feliksdd/poa-sensor/bom/bom.csv

Ref | Qty | Value | MPN | LCSC | Footprint | Assembly | Notes
CELL1 | 1 | KXOB25-14X1F | KXOB25-14X1F-TR |  | POA:KXOB25-14X1F | MANUAL | Manual procurement via group order; DigiKey KXOB25-14X1FCT-ND; no LCSC equivalent assigned
RSH1 | 1 | 1R 0.1% 25ppm/K | RT0805BRD071RL | C865286 | Resistor_SMD:R_0805_2012Metric | FITTED_DIRECT | True Kelvin routing; 0805 shunt
R4 | 1 | 100R | 0603WAF1000T5E | C22775 | Resistor_SMD:R_0603_1608Metric | FITTED_DIRECT
R5 | 1 | 100R | 0603WAF1000T5E | C22775 | Resistor_SMD:R_0603_1608Metric | FITTED_DIRECT
C3 | 1 | 100nF | CC0603KRX7R9BB104 | C14663 | Capacitor_SMD:C_0603_1608Metric | FITTED_DIRECT
U1 | 1 | ADS1115IDGSR | ADS1115IDGSR | C37593 | Package_SO:MSOP-10_3x3mm_P0.5mm | FITTED_DIRECT
J1 | 1 | 3 m / 3 Paare / Loetpads |  |  | POA:POA_Cable_6pad | PCB_FEATURE | No duplicated I2C pullups in DIRECT mode
D1 | 1 | TPD2E2U06DRLR | TPD2E2U06DRLR | C1972959 | Package_TO_SOT_SMD:SOT-553 | FITTED_DIRECT
R12 | 1 | 10R analog filter | 0603WAF100JT5E | C22859 | Resistor_SMD:R_0603_1608Metric | FITTED_DIRECT
C6 | 1 | 1uF | CL21B105KBFNNNE | C28323 | Capacitor_SMD:C_0805_2012Metric | FITTED_DIRECT | 1uF 50V X7R +/-10%; JLCPCB Basic
C1 | 1 | 100nF | CC0603KRX7R9BB104 | C14663 | Capacitor_SMD:C_0603_1608Metric | FITTED_DIRECT
C2 | 1 | 1uF | CL21B105KBFNNNE | C28323 | Capacitor_SMD:C_0805_2012Metric | FITTED_DIRECT | 1uF 50V X7R +/-10%; JLCPCB Basic
R1 | 1 | 47k 0.1% | AR03BTCX4702 | C2828645 | Resistor_SMD:R_0603_1608Metric | FITTED_DIRECT | 0.1% 25ppm/K thin film
NTC1 | 1 | 10k NTC / 0402 | NTCG103JF103FT1 | C209959 | Resistor_SMD:R_0402_1005Metric | FITTED_DIRECT | 10k 1%; B25/50=3380K; 0402 height 0.50+/-0.05mm; cell underside 0.7mm above PCB
R2 | 1 | 47k 0.1% | AR03BTCX4702 | C2828645 | Resistor_SMD:R_0603_1608Metric | FITTED_DIRECT | 0.1% 25ppm/K thin film
R3 | 1 | 47k 0.1% | AR03BTCX4702 | C2828645 | Resistor_SMD:R_0603_1608Metric | FITTED_DIRECT | 0.1% 25ppm/K thin film
C4 | 1 | 100nF | CC0603KRX7R9BB104 | C14663 | Capacitor_SMD:C_0603_1608Metric | FITTED_DIRECT
C7 | 1 | 100nF | CC0603KRX7R9BB104 | C14663 | Capacitor_SMD:C_0603_1608Metric | FITTED_DIRECT
R6 | 1 | 0R DIRECT | 0603WAF0000T5E | C21189 | Resistor_SMD:R_0603_1608Metric | FITTED_DIRECT
R7 | 1 | 0R DIRECT | 0603WAF0000T5E | C21189 | Resistor_SMD:R_0603_1608Metric | FITTED_DIRECT
U2 | 1 | P82B715DR DNP | P82B715DR | C2649394 | Package_SO:SOIC-8_3.9x4.9mm_P1.27mm | DNP_BUFFER_OPTION | Remove R6/R7 before populating buffered option
R8 | 1 | 1k DNP | 0603WAF1001T5E | C21190 | Resistor_SMD:R_0603_1608Metric | DNP_BUFFER_OPTION | JLCPCB Basic; DNP in DIRECT; remove R6/R7 before buffered assembly
R9 | 1 | 1k DNP | 0603WAF1001T5E | C21190 | Resistor_SMD:R_0603_1608Metric | DNP_BUFFER_OPTION | JLCPCB Basic; DNP in DIRECT; remove R6/R7 before buffered assembly
R10 | 1 | 2.2k DNP | 0603WAF2201T5E | C4190 | Resistor_SMD:R_0603_1608Metric | DNP_BUFFER_OPTION | Remove R6/R7 before populating buffered option
R11 | 1 | 2.2k DNP | 0603WAF2201T5E | C4190 | Resistor_SMD:R_0603_1608Metric | DNP_BUFFER_OPTION | Remove R6/R7 before populating buffered option
C5 | 1 | 100nF DNP | CC0603KRX7R9BB104 | C14663 | Capacitor_SMD:C_0603_1608Metric | DNP_BUFFER_OPTION | Remove R6/R7 before populating buffered option
