feliksdd/poa-sensor/hardware/3dmodels/TDK_NTCG103JF103FT1.step

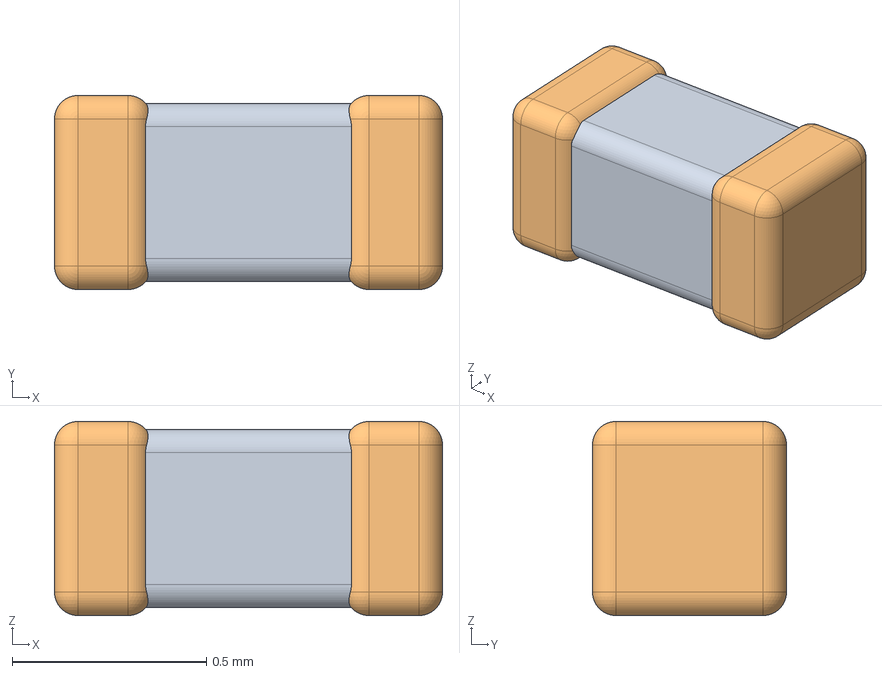
[picture p1: CAD file, 2026-11-11]
hardware/3dmodels/TDK_NTCG103JF103FT1.step
1.00 x 0.5 x 0.5 mm
