feliksdd/poa-sensor/hardware/3dmodels/KXOB25-14X1F.step

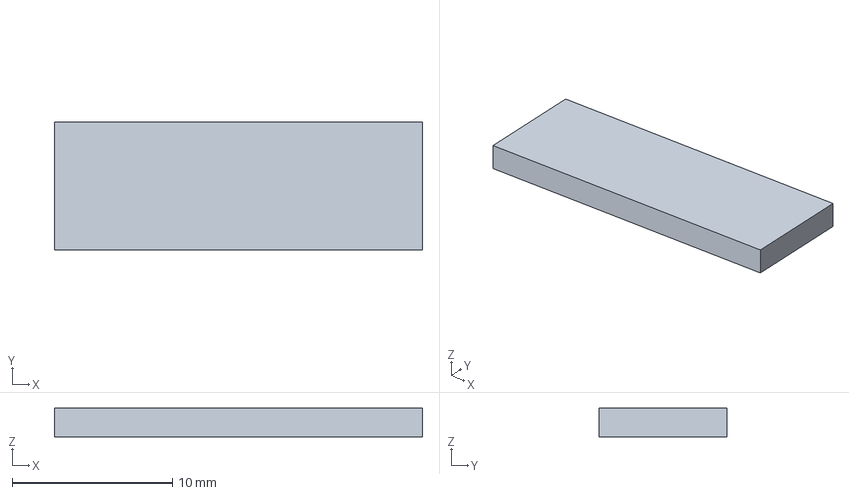
[picture p2: CAD file, 2026-09-30]
hardware/3dmodels/KXOB25-14X1F.step
23.0 x 8.00 x 1.80 mm
