feliksdd/poa-sensor/mechanical/manufacturer/Kradex_ZP60_60_40.pdf

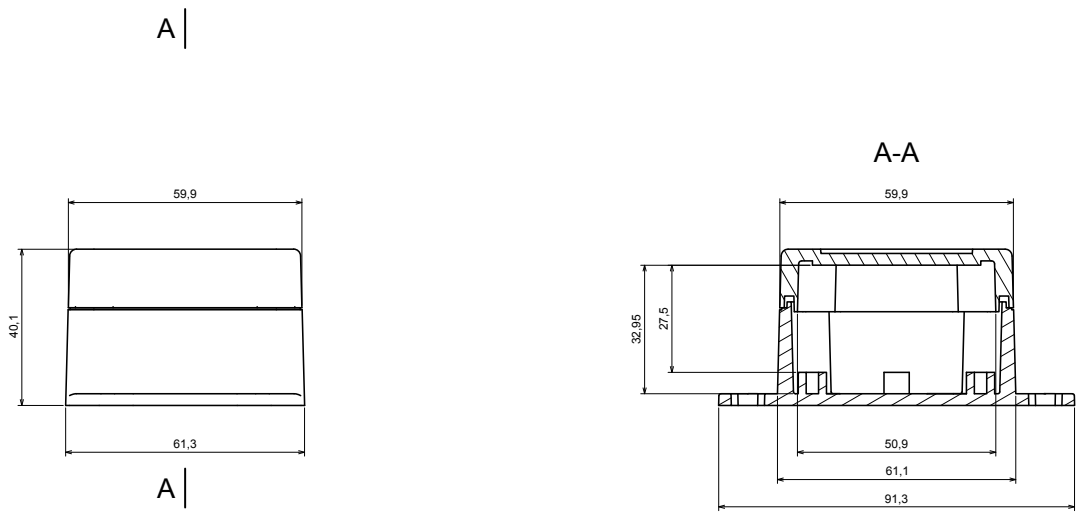
[picture p3: page 1]
Product model Format: A3 Scale 1:1; Tolerance: +/- 0.5 Material: PC, ABS Enclosure ZP60.60.40U TM - Assembly All rights reserved, Copyright Kradex 2020 AA

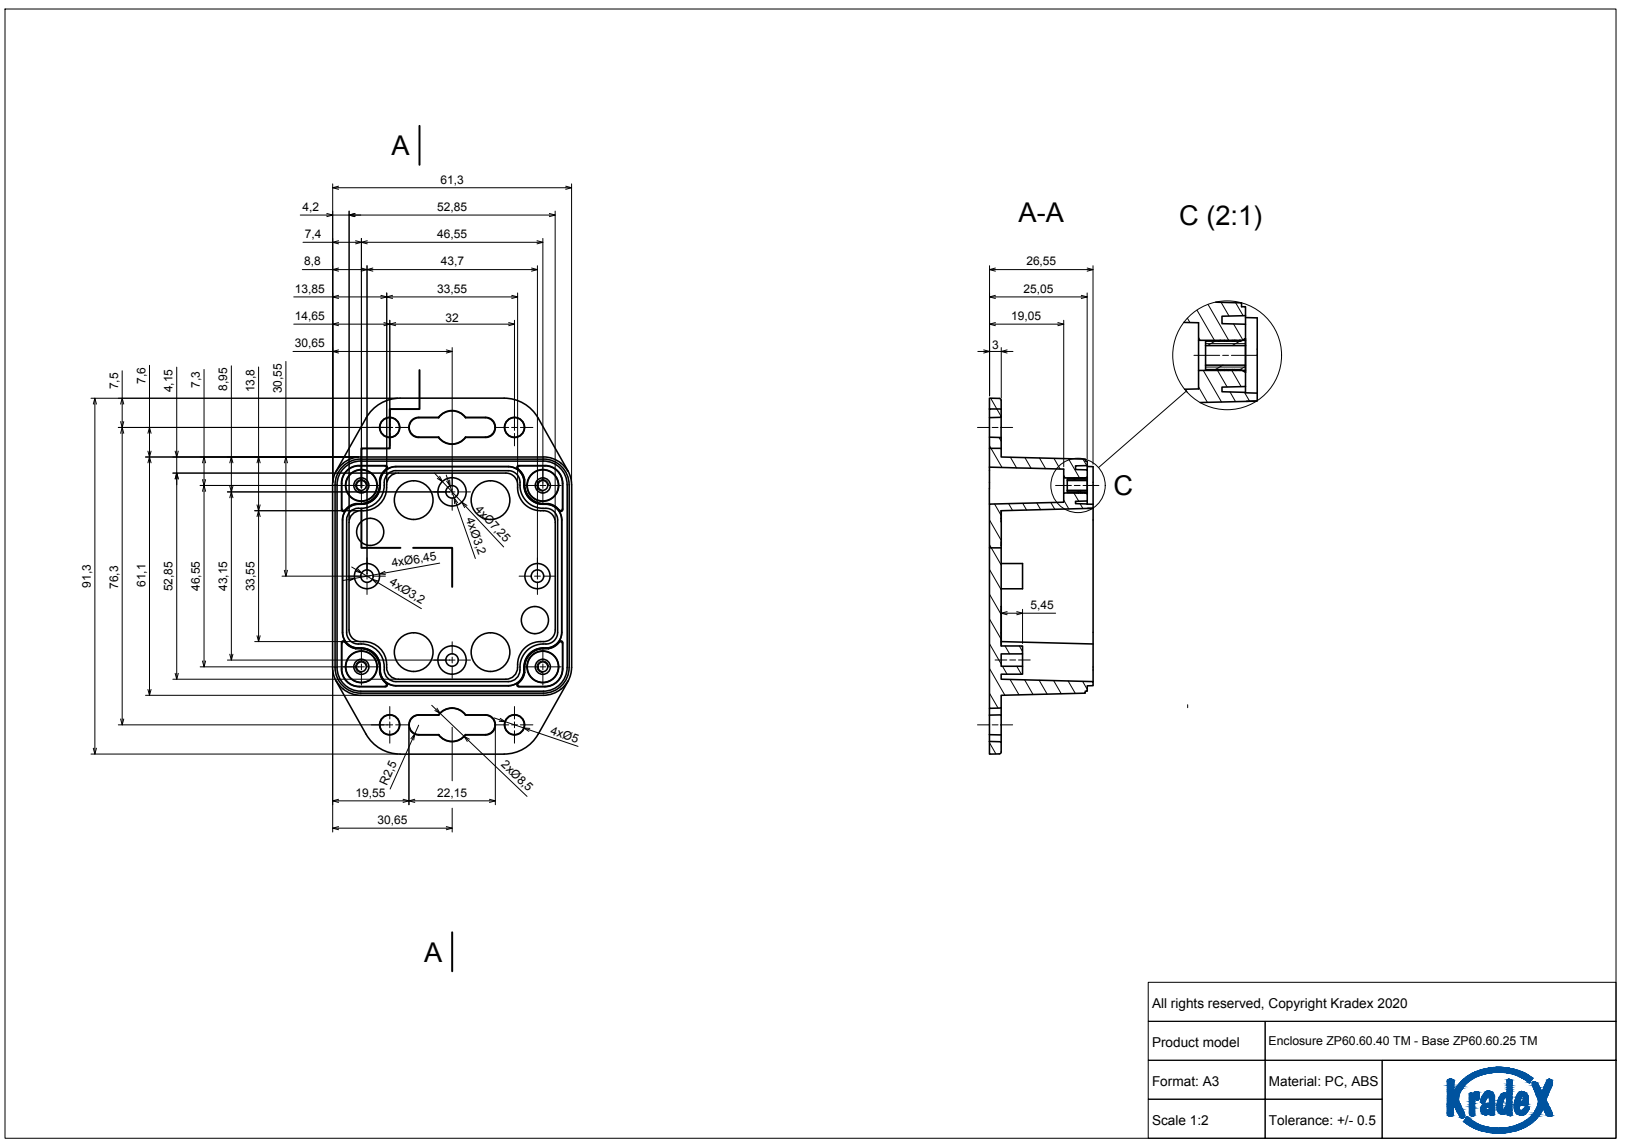
[picture p4: page 2]
Product model Format: A3 Scale 1:2; Tolerance: +/- 0.5 Material: PC, ABS Enclosure ZP60.60.40 TM - Base ZP60.60.25 TM All rights reserved, Copyright Kradex 2020

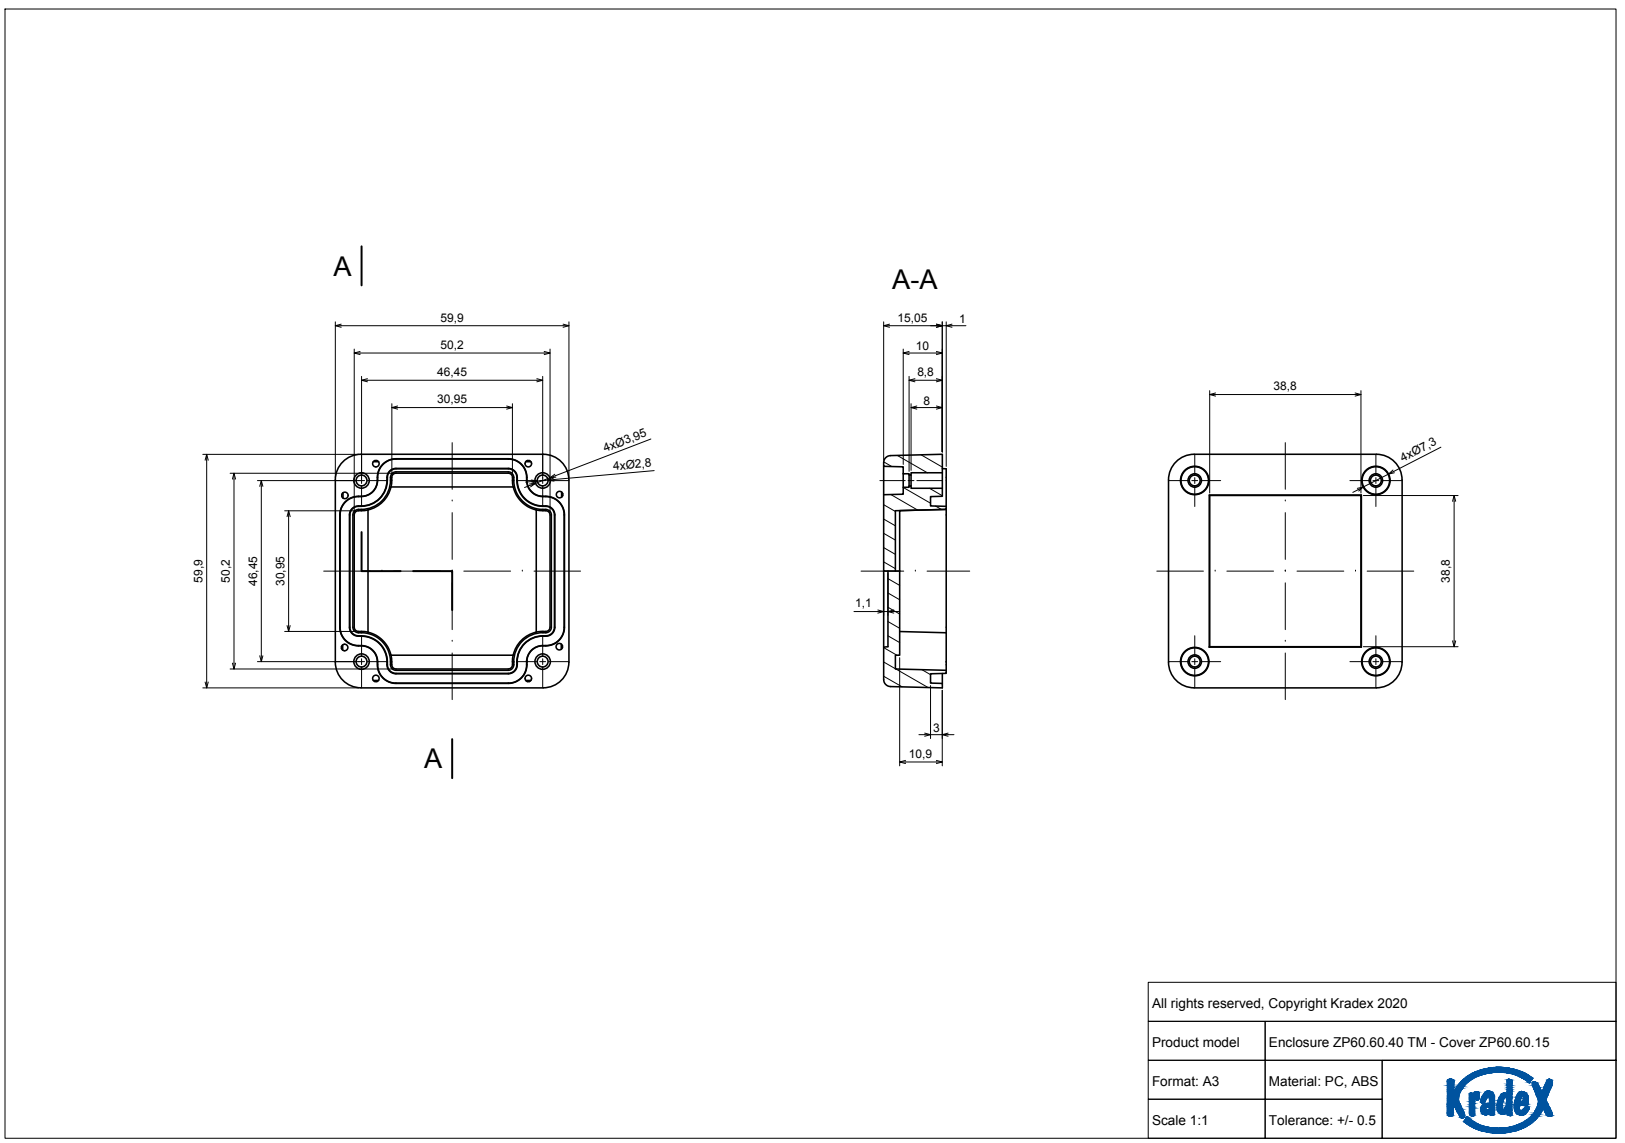
[picture p5: page 3]
Product model Format: A3 Scale 1:1; Tolerance: +/- 0.5 Material: PC, ABS Enclosure ZP60.60.40 TM - Cover ZP60.60.15 All rights reserved, Copyright Kradex 2020 A
