feliksdd/poa-sensor/hardware/poa-sensor.pdf

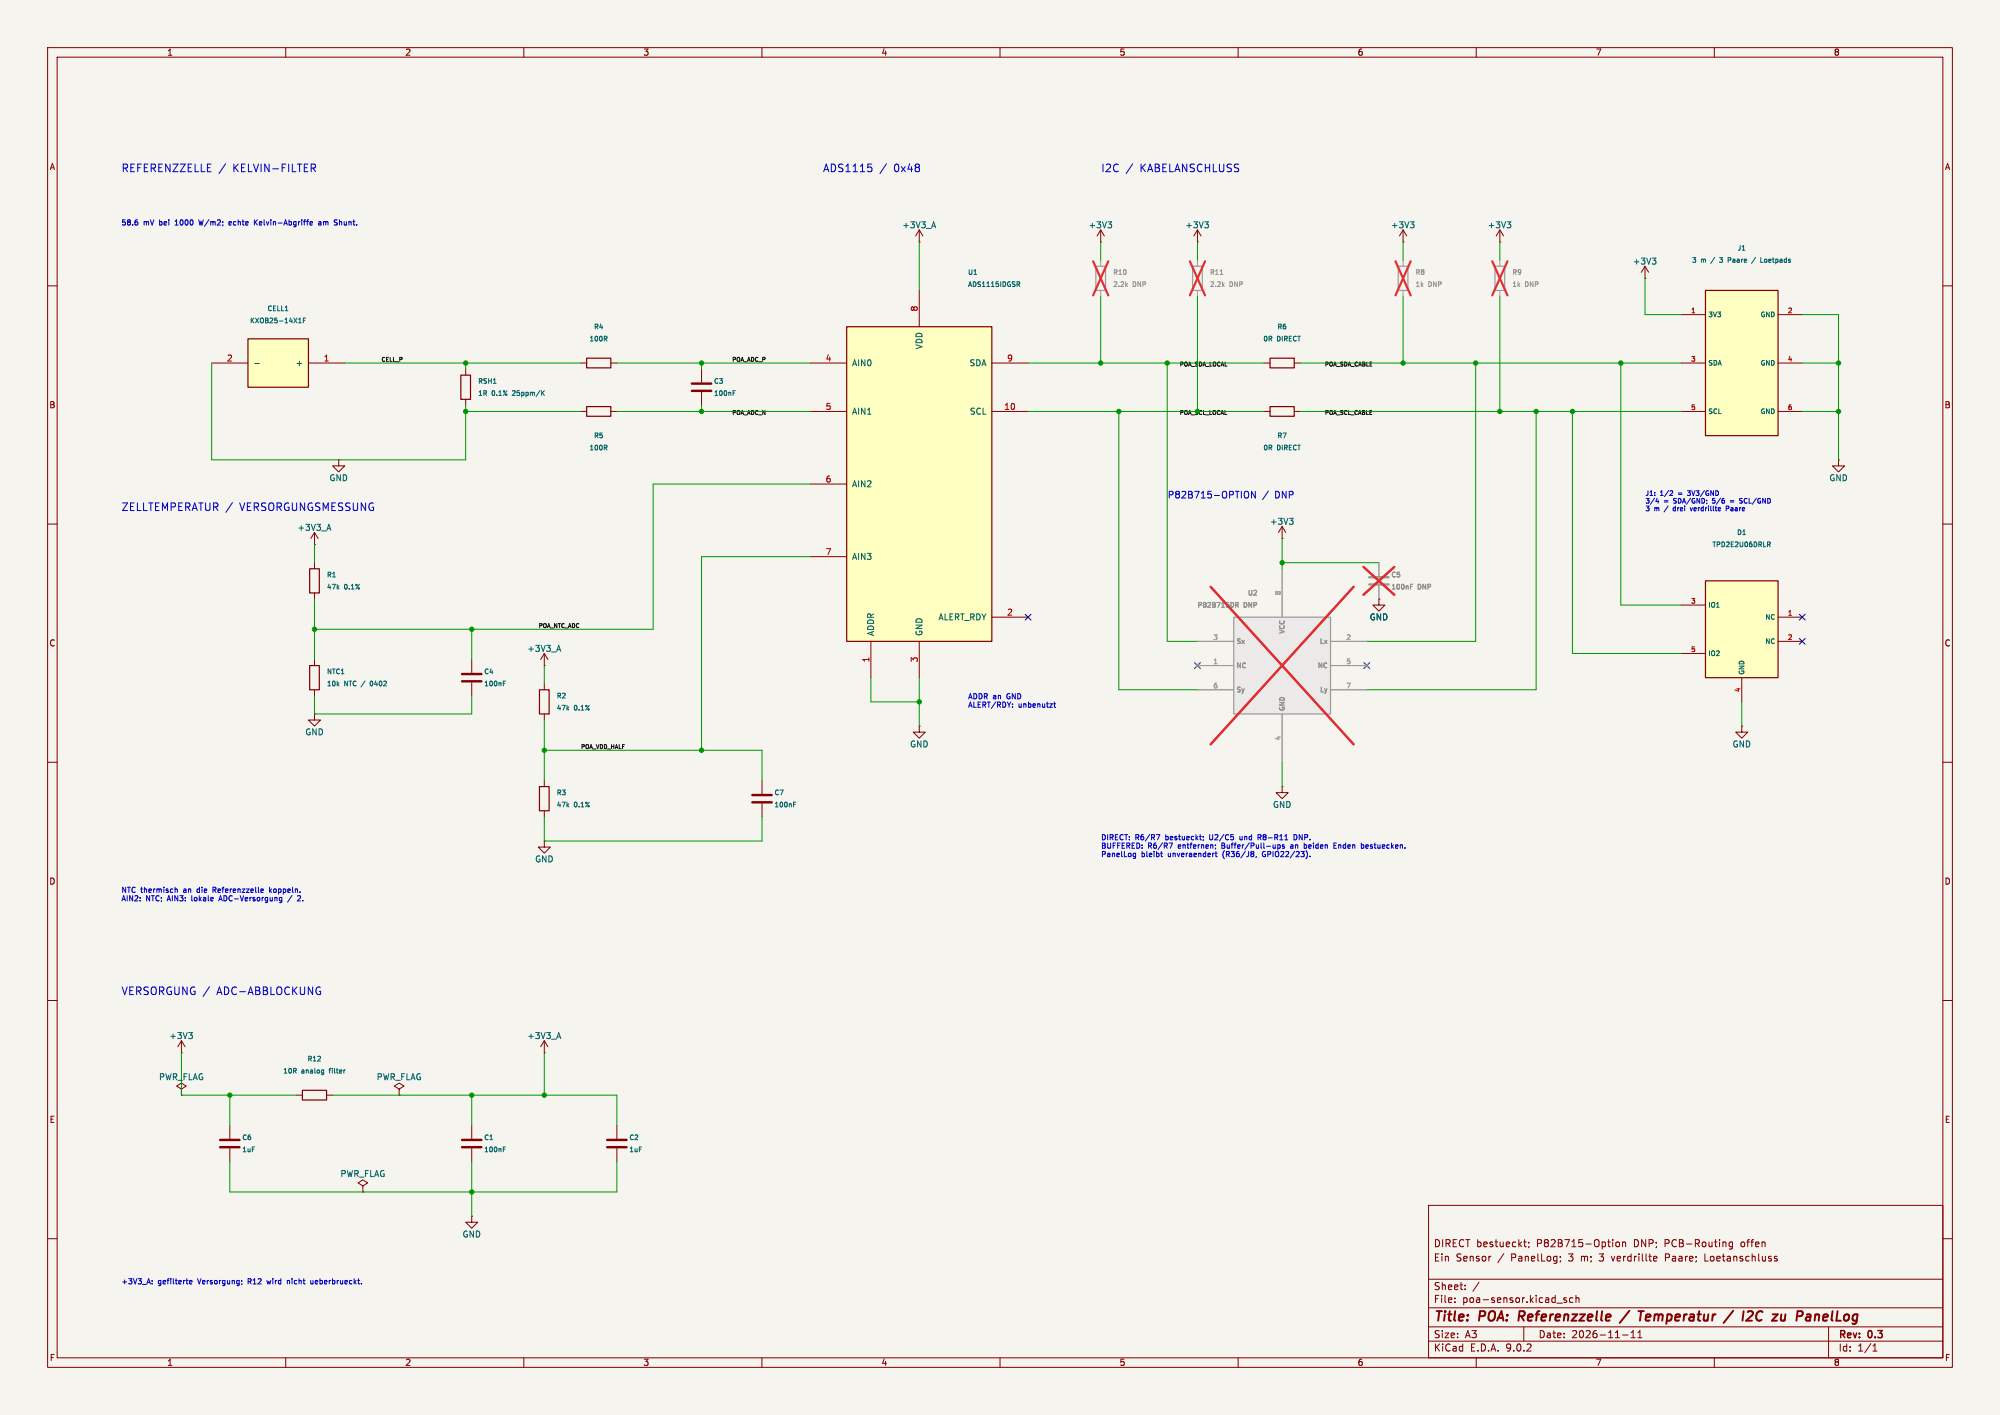
[picture p6: page 1]
