feliksdd/poa-sensor/hardware/poa-sensor.kicad_pcb

## KiCad design hardware/poa-sensor.kicad_pcb (2026-11-12)

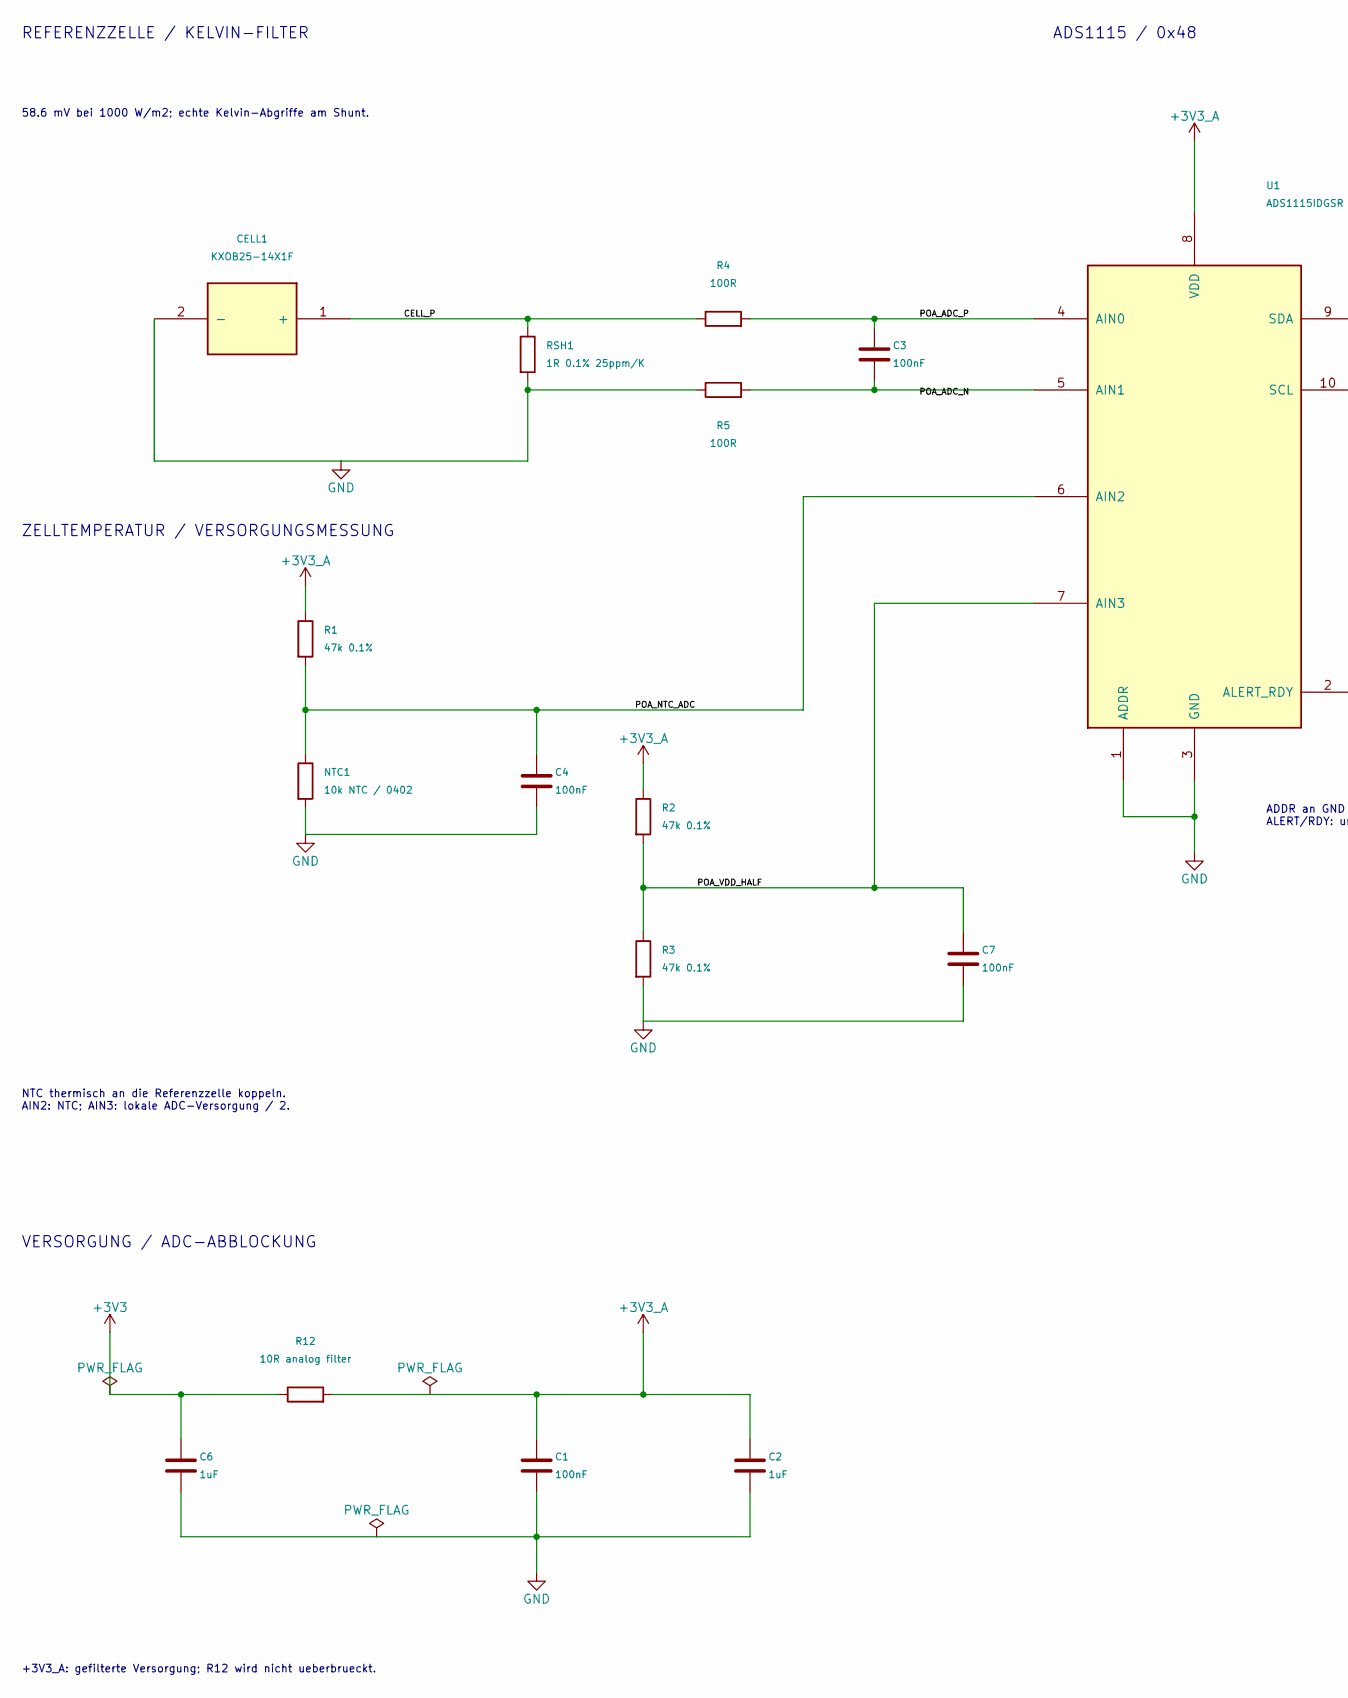
[picture p7: schematic poa-sensor.kicad_sch, POA: Referenzzelle / Temperatur / I2C zu PanelLog, part in row 1, column 1]

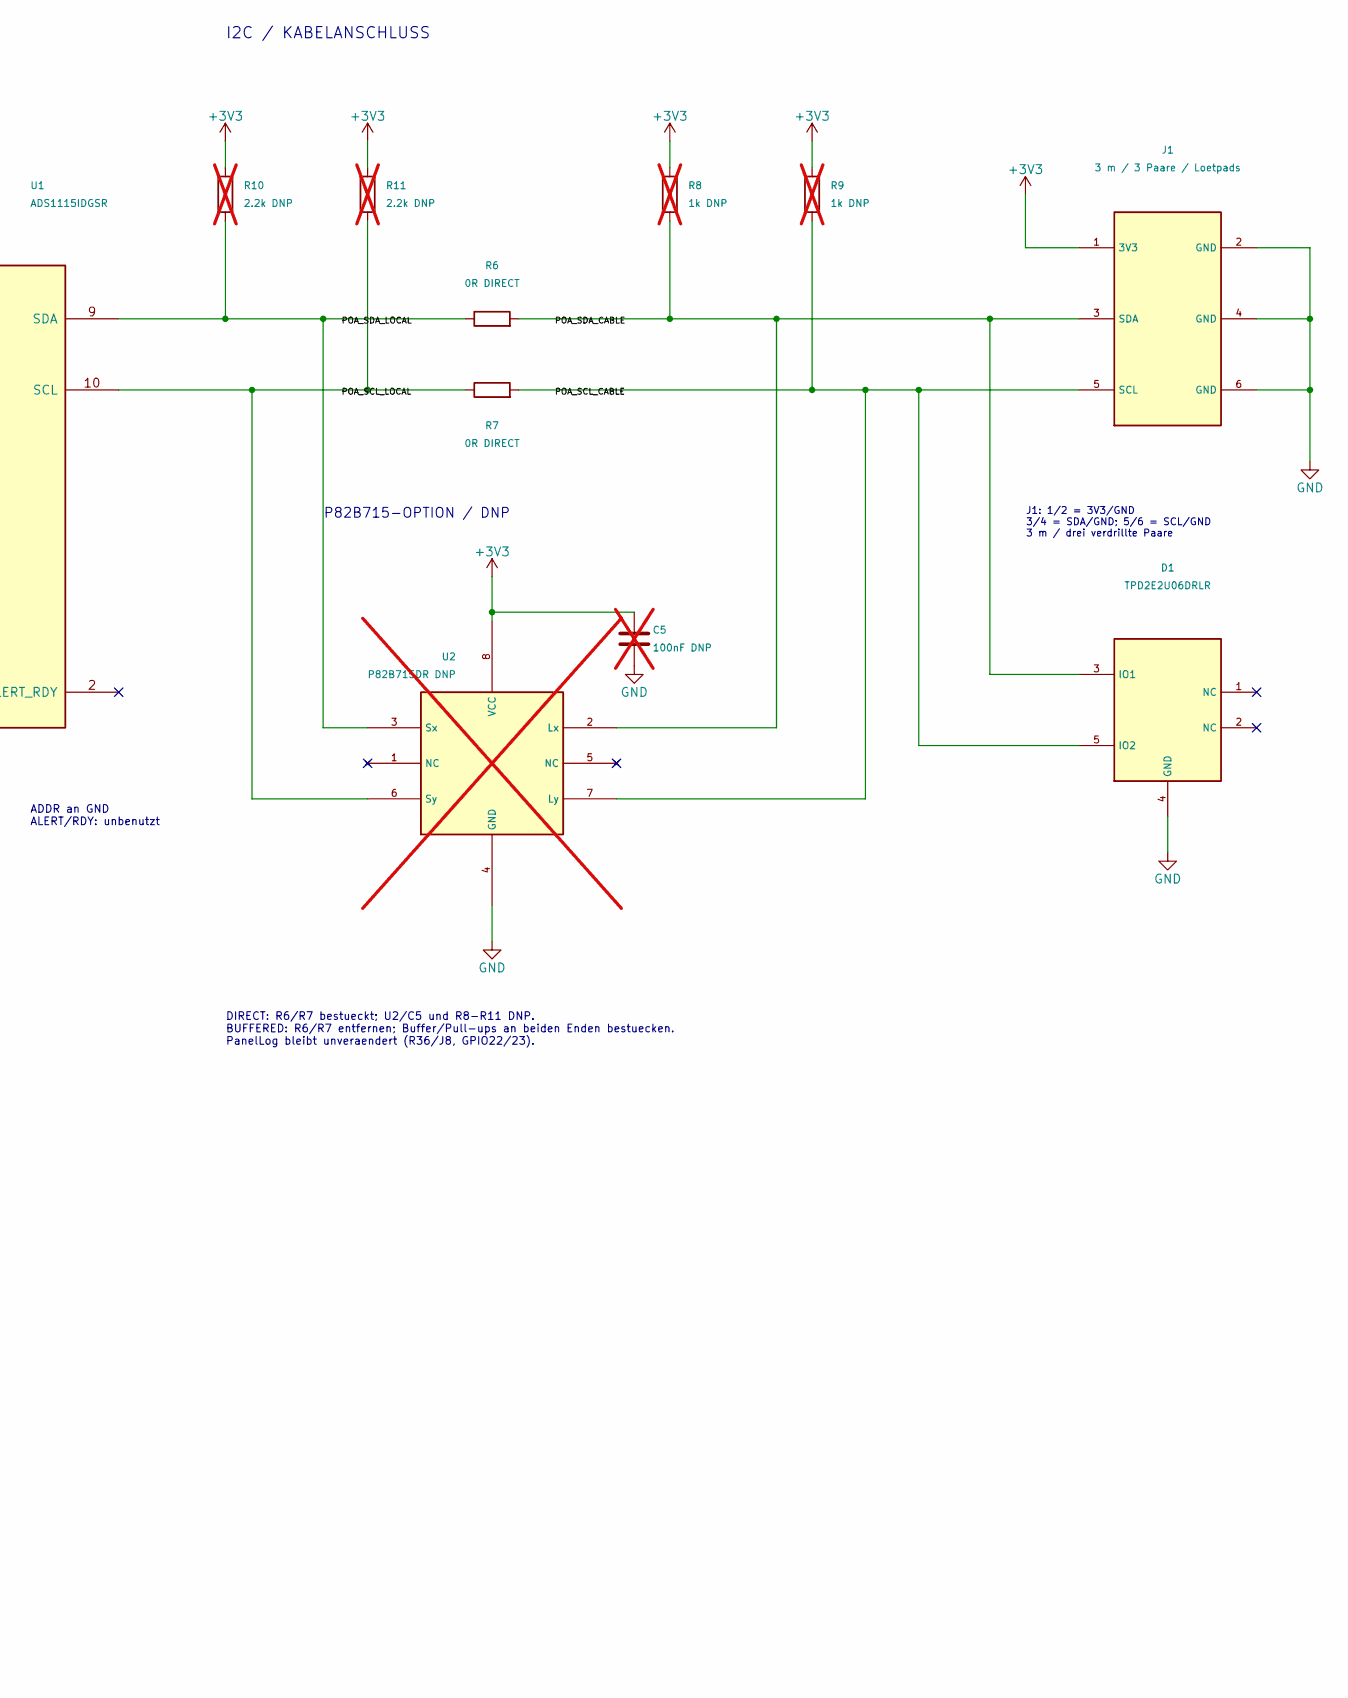
[picture p8: schematic poa-sensor.kicad_sch, POA: Referenzzelle / Temperatur / I2C zu PanelLog, part in row 1, column 2]

Parts:
C1, C3, C4, C7: 100nF; C_0603_1608Metric; MPN CC0603KRX7R9BB104; LCSC C14663
C2, C6: 1uF; C_0805_2012Metric; MPN CL21B105KBFNNNE; LCSC C28323
C5: 100nF DNP; C_0603_1608Metric; MPN CC0603KRX7R9BB104; LCSC C14663; not fitted
CELL1: KXOB25-14X1F; MPN KXOB25-14X1F-TR
D1: TPD2E2U06DRLR; SOT-553; MPN TPD2E2U06DRLR; LCSC C1972959
J1: 3 m / 3 Paare / Loetpads; POA_Cable_6pad
NTC1: 10k NTC / 0402; R_0402_1005Metric; MPN NTCG103JF103FT1; LCSC C209959
R1, R2, R3: 47k 0.1%; R_0603_1608Metric; MPN AR03BTCX4702; LCSC C2828645
R4, R5: 100R; R_0603_1608Metric; MPN 0603WAF1000T5E; LCSC C22775
R6, R7: 0R DIRECT; R_0603_1608Metric; MPN 0603WAF0000T5E; LCSC C21189
R8, R9: 1k DNP; R_0603_1608Metric; MPN 0603WAF1001T5E; LCSC C21190; not fitted
R10, R11: 2.2k DNP; R_0603_1608Metric; MPN 0603WAF2201T5E; LCSC C4190; not fitted
R12: 10R analog filter; R_0603_1608Metric; MPN 0603WAF100JT5E; LCSC C22859
RSH1: 1R 0.1% 25ppm/K; R_0805_2012Metric; MPN RT0805BRD071RL; LCSC C865286
U1: ADS1115IDGSR; MSOP-10_3x3mm_P0.5mm; MPN ADS1115IDGSR; LCSC C37593
U2: P82B715DR DNP; SOIC-8_3.9x4.9mm_P1.27mm; MPN P82B715DR; LCSC C2649394; not fitted

Connections:
+3V3: C5.1, C6.1, J1.1 (3V3), R8.1, R9.1, R10.1, R11.1, R12.1, U2.8 (VCC)
+3V3_A: C1.1, C2.1, R1.1, R2.1, R12.2, U1.8 (VDD)
/CELL_P: CELL1.1 (+), R4.1, RSH1.1
/POA_ADC_N: C3.2, R5.2, U1.5 (AIN1)
/POA_ADC_P: C3.1, R4.2, U1.4 (AIN0)
/POA_NTC_ADC: C4.1, NTC1.1, R1.2, U1.6 (AIN2)
/POA_SCL_CABLE: D1.5 (IO2), J1.5 (SCL), R7.2, R9.2, U2.7 (Ly)
/POA_SCL_LOCAL: R7.1, R11.2, U1.10 (SCL), U2.6 (Sy)
/POA_SDA_CABLE: D1.3 (IO1), J1.3 (SDA), R6.2, R8.2, U2.2 (Lx)
/POA_SDA_LOCAL: R6.1, R10.2, U1.9 (SDA), U2.3 (Sx)
/POA_VDD_HALF: C7.1, R2.2, R3.1, U1.7 (AIN3)
GND: C1.2, C2.2, C4.2, C5.2, C6.2, C7.2, CELL1.2 (-), D1.4 (GND), J1.2 (GND), J1.4 (GND), J1.6 (GND), NTC1.2, R3.2, R5.1, RSH1.2, U1.1 (ADDR), U1.3 (GND), U2.4 (GND)

Notes on the sheet:
NTC thermisch an die Referenzzelle koppeln. AIN2: NTC; AIN3: lokale ADC-Versorgung / 2.
VERSORGUNG / ADC-ABBLOCKUNG
P82B715-OPTION / DNP
J1: 1/2 = 3V3/GND 3/4 = SDA/GND; 5/6 = SCL/GND 3 m / drei verdrillte Paare
REFERENZZELLE / KELVIN-FILTER
ADS1115 / 0x48
DIRECT: R6/R7 bestueckt; U2/C5 und R8-R11 DNP. BUFFERED: R6/R7 entfernen; Buffer/Pull-ups an beiden Enden bestuecken. PanelLog bleibt unveraendert (R36/J8, GPIO22/23).
58.6 mV bei 1000 W/m2; echte Kelvin-Abgriffe am Shunt.
ZELLTEMPERATUR / VERSORGUNGSMESSUNG
ADDR an GND ALERT/RDY: unbenutzt
I2C / KABELANSCHLUSS
+3V3_A: gefilterte Versorgung; R12 wird nicht ueberbrueckt.

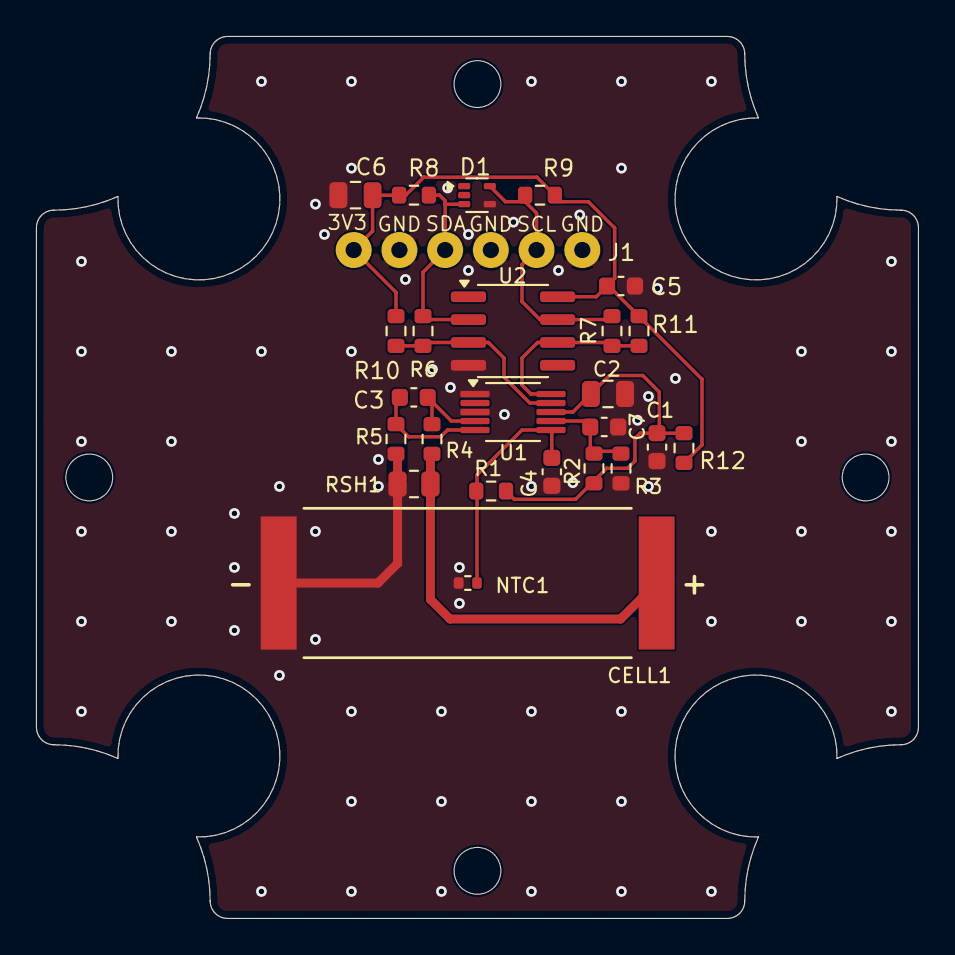
[picture p9: board poa-sensor.kicad_pcb from above]

Board: 2 copper layers, 49.0 x 49.0 mm, 30 parts (0 on the bottom side), 12 nets.

Other parts of the board:
H1, H2, H3, H4: NPTH 2.6mm; Kradex_ZP60_MountingHole_2.6mm
