feliksdd/poa-sensor/(commit log)

2026-09-28 Initialize POA sensor repository
2026-09-28 Add KiCad-oriented gitignore
2026-09-28 Add initial concrete design BOM
    [bom.csv]
2026-09-28 Concretize JLCPCB/LCSC BOM selections
    [bom.csv]
2026-09-28 Optimize BOM and freeze schematic v0.1 components
    [bom.csv]
2026-09-28 Freeze electrical architecture for schematic v0.1
2026-09-28 Add KiCad legacy symbols for schematic v0.1
2026-09-28 Add KiCad schematic v0.1
    [poa-sensor.sch]
2026-09-28 Document KiCad schematic v0.1 workflow
2026-09-28 Fix LF crystal placement and E73 ground connection in schematic v0.1
    [poa-sensor.sch]
2026-09-28 poa-sensor.kicad_sch added
    [poa-sensor.kicad_sch]
2026-09-28 Add project-local KiCad footprint library
2026-09-28 Add verified E73 module footprint
2026-09-28 Add KXOB25 reference-cell footprint
2026-09-28 Add compact five-pad SWD pogo footprint
2026-09-28 Add direct-wire solder-pad footprint
2026-09-28 Refine BOM for PCB layout and under-cell NTC
    [bom.csv]
2026-09-28 Document PCB baseline and under-cell NTC strategy
2026-09-28 Add initial PCB and enclosure placement baseline
2026-09-28 Document custom footprint sources and release checks
2026-09-28 Add reproducible KiCad ERC and DRC CI checks
2026-09-28 Add poa-sensor.kicad_sch
2026-09-28 Add schematic normalization tool
2026-09-28 Check normalized KiCad metadata in CI
2026-09-28 Normalize converted schematic before CI checks
2026-09-28 Add KiCad PCB placement template
    [poa-sensor-layout-template.kicad_pcb]
2026-09-28 Document native KiCad PCB workflow
2026-09-28 Fix KiCad CLI Docker invocation
2026-09-28 Expose KiCad ERC and DRC reports in CI
2026-09-28 Add native KiCad project symbol library
2026-09-28 Correct native custom symbol pin coordinates
2026-09-28 Normalize legacy schematic wire geometry
2026-09-28 Clean converted geometry and configure KiCad CI libraries
2026-09-28 Create native KiCad PCB baseline
    [poa-sensor.kicad_pcb]
2026-09-28 Add deterministic PCB placement tool
2026-09-28 Gate PCB DRC until schematic footprints are imported
2026-09-28 Document native PCB and deterministic placement workflow
2026-09-28 Add parts to PCB
    [poa-sensor.kicad_pcb, poa-sensor.kicad_sch]
2026-09-28 Fix ADS1115 KiCad footprint library path
2026-09-28 Document ADS1115 footprint fix before PCB sync
2026-09-28 Include ADS1115 footprint correction in KiCad CI
2026-09-28 Fix U2 footprint normalizer for embedded KiCad symbol
2026-09-28 Add project-local ADS1115 VSSOP-10 footprint
2026-09-28 Use project-local ADS1115 footprint
2026-09-29 mechanical: match PCB template to Hammond 1554BPL profile
    [poa-sensor-layout-template.kicad_pcb]
2026-09-29 docs: adopt exact Hammond 1554BPL PCB mechanics
2026-09-29 docs: identify 1554BPL as PCB mechanical source
2026-09-29 pcb: adapt canonical placement to Hammond 1554BPL mechanics
2026-09-29 tools: synchronize PCB mechanics from 1554BPL template
2026-09-29 docs: update PCB workflow for 1554BPL mechanics
2026-09-29 ci: apply 1554BPL mechanics to production PCB
2026-09-29 pcb: apply Hammond 1554BPL mechanics
    [poa-sensor.kicad_pcb]
2026-09-29 Match PCB mechanics to Hammond 1554BPL steel panel
    * mechanical: match PCB template to Hammond 1554BPL profile
    * docs: adopt exact Hammond 1554BPL PCB mechanics
    * docs: identify 1554BPL as PCB mechanical source
    * pcb: adapt canonical placement to Hammond 1554BPL mechanics
    * tools: synchronize PCB mechanics from 1554BPL template
    * docs: update PCB workflow for 1554BPL mechanics
    * ci: apply 1554BPL mechanics to production PCB
    * tools: allow partial placement during mechanical bring-up
    * ci: allow known missing U2 during mechanical application
    * pcb: apply Hammond 1554BPL mechanics
    * mechanical: synchronize placement guides with 1554BPL template
    * pcb: apply Hammond 1554BPL mechanics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
    [poa-sensor-layout-template.kicad_pcb, poa-sensor.kicad_pcb]
2026-09-29 chore: temporarily inspect official 1554BPL CAD geometry
2026-09-29 chore: retry official 1554BPL CAD download with browser headers
2026-09-29 mechanical: correct 1554BPL panel outline
    [poa-sensor-layout-template.kicad_pcb, poa-sensor.kicad_pcb]
2026-09-29 mechanical: fix 1554BPL arc direction
    [poa-sensor-layout-template.kicad_pcb, poa-sensor.kicad_pcb]
2026-09-30 hardware: add custom component 3D models
    [E73-2G4M08S1C.step, KXOB25-14X1F.step, poa-sensor.kicad_pcb]
2026-10-29 docs: split POA sensor scope from PanelLog
2026-10-29 docs: mark module-temperature channel legacy
2026-10-29 docs: remove module probe from target mechanics
2026-10-29 docs: split module temperature into PanelLog
2026-11-09 feat(poa): add native KiCad 10 wired ADS1115 and DNP P82B715 schematic draft
    [poa-sensor-wired.kicad_sch]
2026-11-09 feat(poa): add 6-pad solderable UV sensor-cable footprint
2026-11-09 feat(poa): add DNP local S-side pull-ups to enable future P82B715 buffered assembly
    [poa-sensor-wired.kicad_sch]
2026-11-09 feat(poa): add matching low-capacitance TPD2E2U06 cable-side ESD device
    [poa-sensor-wired.kicad_sch]
2026-11-09 bom(poa): add wired sensor/interface bill of materials and DNP groups
    [wired_rev0_selection.csv]
2026-11-09 Review wired POA hardware: correct KiCad libraries and routing, audit LCSC BOM, add native checks
    [poa-sensor-wired.kicad_sch, reviewed_selection_2026-11-09.csv, wired_rev0_selection.csv]
2026-11-10 Make wired reference-cell sensor the primary schematic
    [bom.csv, poa-sensor-wired.kicad_sch, poa-sensor-wireless-legacy.kicad_pcb, poa-sensor-wireless-legacy.kicad_sch, poa-sensor-wireless-legacy.sch, poa-sensor.kicad_sch, wired_rev0_selection.csv, wireless_legacy_bom.csv]
2026-11-10 Align host notes with current PanelLog production baseline
2026-11-10 Use unchanged PanelLog R36 interface without host modifications
    [poa-sensor.kicad_sch]
2026-11-10 Draw POA signals directly and group circuits with power symbols
    [poa-sensor.kicad_sch]
2026-11-10 Keep only current POA sources and concise documentation
    [E73-2G4M08S1C.step, poa-outline.kicad_pcb, poa-sensor-layout-template.kicad_pcb, poa-sensor-wireless-legacy.kicad_pcb, poa-sensor-wireless-legacy.kicad_sch, poa-sensor-wireless-legacy.sch, reviewed_selection_2026-11-09.csv, wired_rev0_selection.csv]
2026-11-10 change schematic to KiCad10
    [poa-sensor.kicad_sch]
2026-11-10 Use Kradex enclosure and create schematic-linked PCB placement
    [poa-outline.kicad_pcb, poa-sensor.kicad_pcb]
2026-11-10 Pin PCB footprint libraries and preserve empty schematic fields
    [poa-sensor.kicad_pcb]
2026-11-10 Optimize LCSC sourcing and synchronize component metadata
    Use stocked Samsung 25V X7R capacitors and Yageo optional pull-ups. Select stocked Viking 47k 0.1% resistors with documented 25ppm/K TCR. Keep the reference cell as a separate DigiKey purchase and preserve all CAD geometry and connectivity.
    [bom.csv, poa-sensor.kicad_pcb, poa-sensor.kicad_sch]
2026-11-11 part placing
    [poa-sensor.kicad_pcb]
2026-11-11 Apply Economic PCBA component changes to current placement
    [TDK_NTCG103JF103FT1.step, bom.csv, poa-sensor.kicad_pcb, poa-sensor.kicad_sch]
2026-11-11 Resolve DRC issues in current component placement
    [poa-sensor.kicad_pcb]
2026-11-11 Synchronize embedded Economic PCBA footprints
    [poa-sensor.kicad_pcb]
2026-11-11 Normalize unpolarized Economic PCBA footprints
    [poa-sensor.kicad_pcb]
2026-11-11 PCB routing
    [poa-sensor.kicad_pcb]
2026-11-11 Add board-outline ground pours and document POA measurement
    [poa-sensor.kicad_pcb]
2026-11-11 close missing gnd connection
    [poa-sensor.kicad_pcb]
2026-11-11 Correct POA fabrication status after routed PCB and GND closure
2026-11-11 Isolate Kelvin sense and stitch POA ground planes
    [poa-sensor.kicad_pcb]
2026-11-12 Final production release
    [poa-sensor.kicad_pcb]
